sadman-showmik/Electromagnetic-Coupling-PCB/EM_Coupling/EM_Coupling_BOM.csv

Reference | Value | Footprint | QUANTITY
C1,C2,C3,C4,C9 | 0.1uF | Capacitor_THT:CP_Radial_Tantal_D6.0mm_P5.00mm | 5
C5,C7 | 0.1uF 250V film | Capacitor_THT:C_Rect_L13.0mm_W6.0mm_P10.00mm_FKS3_FKP3_MKS4 | 2
C6 | 470uF | Capacitor_THT:CP_Radial_Tantal_D7.0mm_P5.00mm | 1
C8 | 0.33uF | Capacitor_THT:CP_Radial_Tantal_D7.0mm_P5.00mm | 1
C10 | 10nF | Capacitor_THT:CP_Radial_Tantal_D6.0mm_P5.00mm | 1
C11 | 1nF | Capacitor_THT:CP_Radial_Tantal_D6.0mm_P5.00mm | 1
D1 | 1N5919BG | 3D_Models:DIOAD1405W86L465D235 | 1
D2,D3,D4,D5 | 1N4148 | 3D_Models:DIOAD1068W53L380D172 | 4
IC1 | IR2302SPBF | 3D_Models:SOIC127P600X175-8N | 1
IC2 | LM7805CT | 3D_Models:TO254P470X1028X1955-3P | 1
J1,J2,J3,J4,J5 | PinHeader_1x02 | Connector_PinHeader_2.54mm:PinHeader_1x02_P2.54mm_Vertical | 5
Q1,Q2 | IRFZ44NPBF | 3D_Models:TO254P483X1016X1994-3P | 2
R1 | 1k | Resistor_THT:R_Axial_DIN0204_L3.6mm_D1.6mm_P7.62mm_Horizontal | 1
R2 | 100 | Resistor_THT:R_Axial_DIN0204_L3.6mm_D1.6mm_P7.62mm_Horizontal | 1
R3 | 10 | Resistor_THT:R_Axial_DIN0204_L3.6mm_D1.6mm_P7.62mm_Horizontal | 1
R4 | 9.09k | Resistor_THT:R_Axial_DIN0204_L3.6mm_D1.6mm_P7.62mm_Horizontal | 1
S1 | EG1218 | 3D_Models:EG1218 | 1
U1 | NE555P | Package_DIP:DIP-8_W7.62mm | 1
