sadman-showmik/Electromagnetic-Coupling-PCB/EM_Coupling/EM_Coupling.pdf

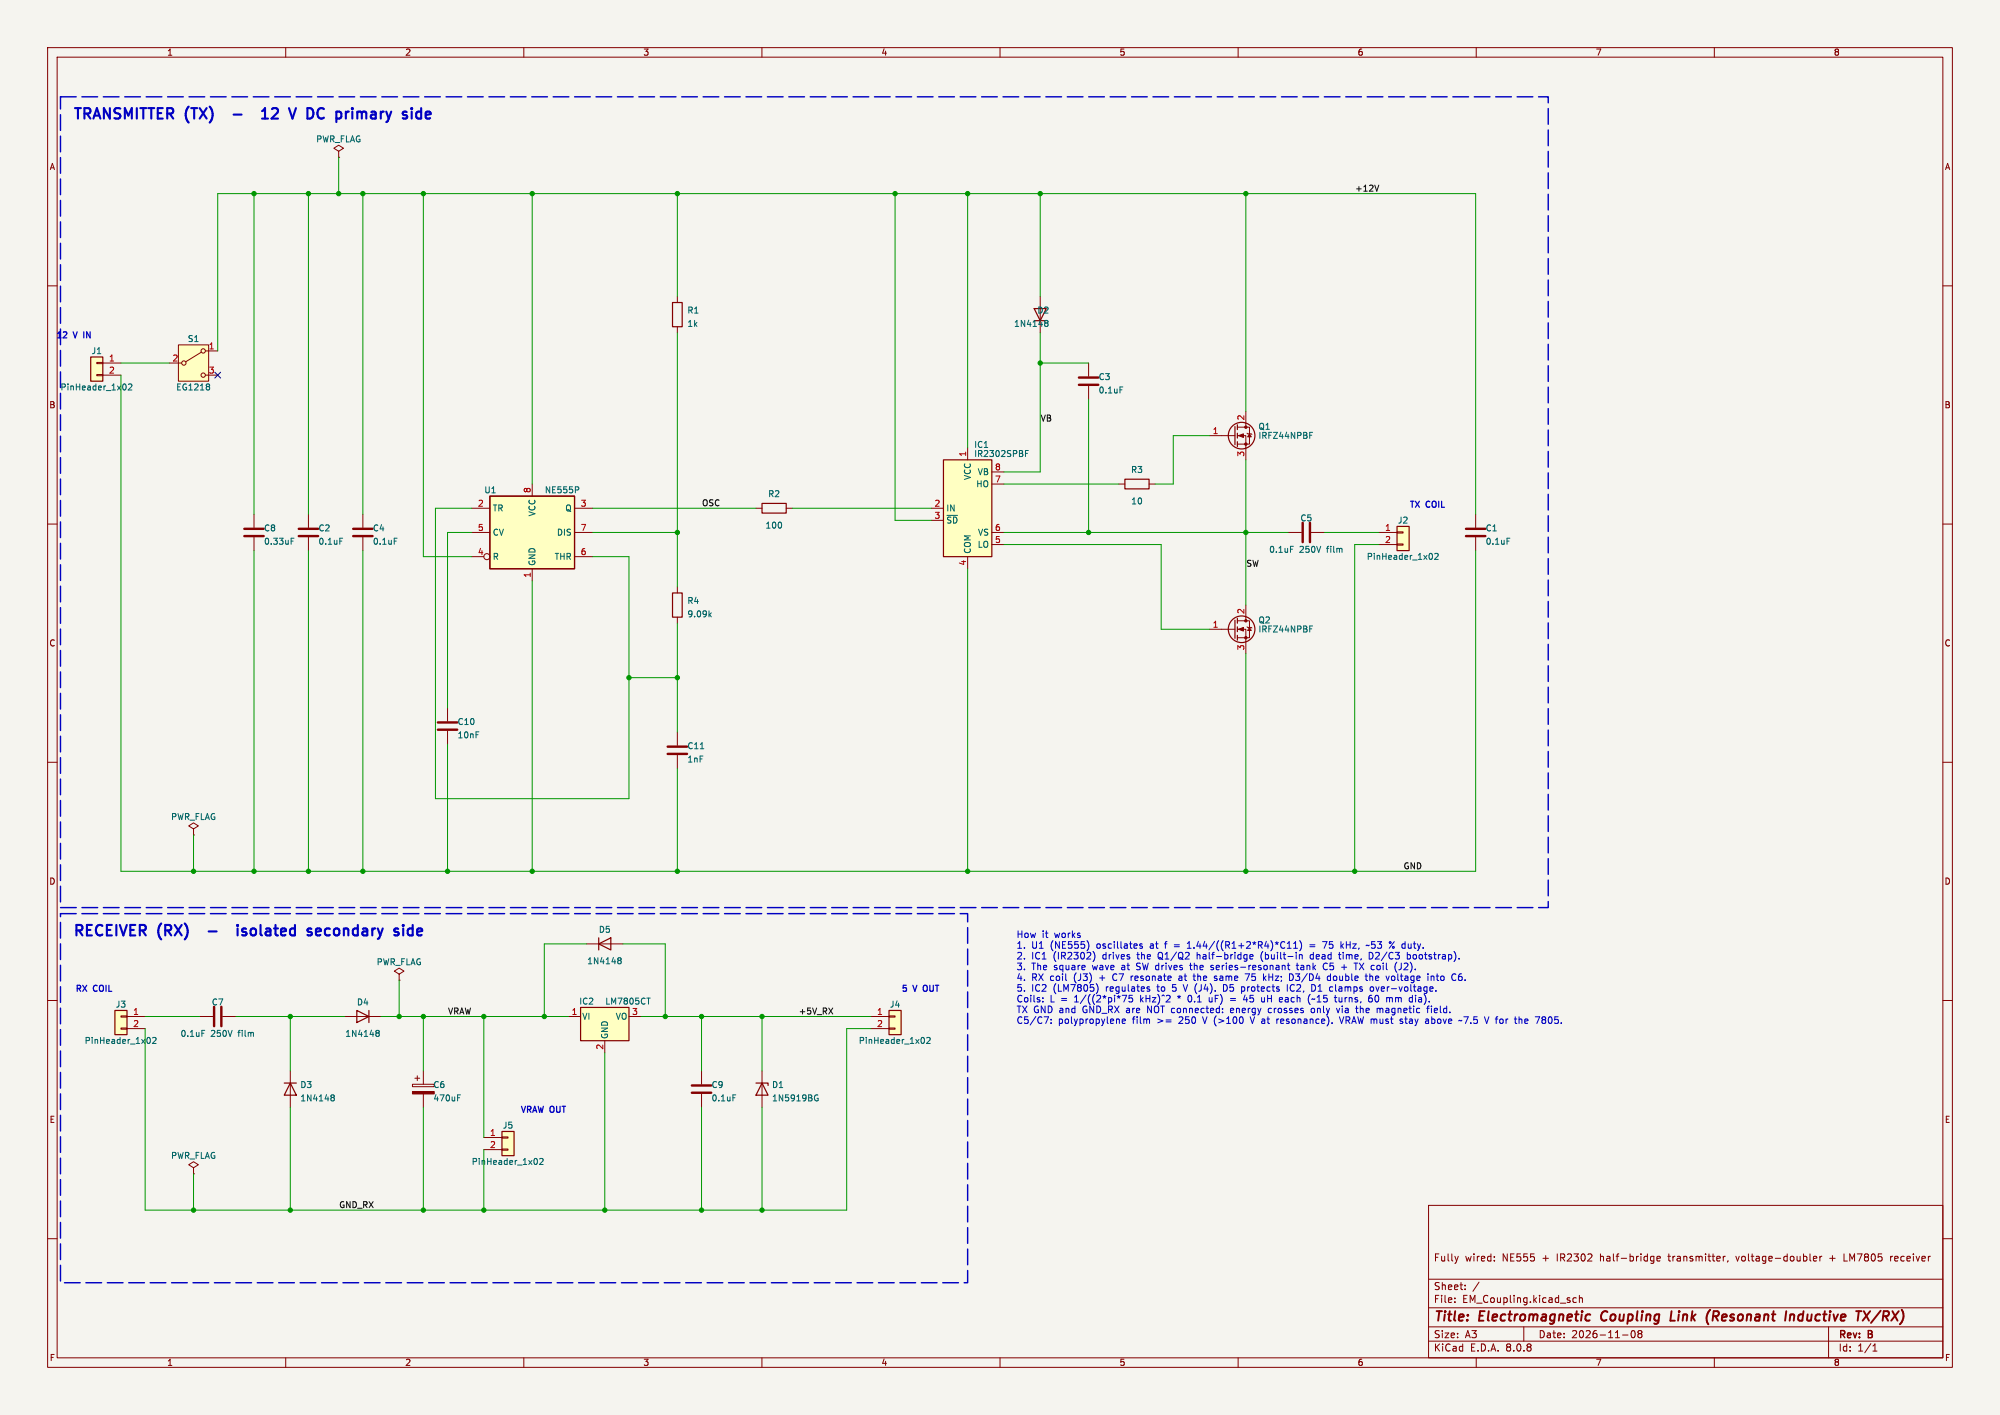
[picture p1: page 1]
