sadman-showmik/Electromagnetic-Coupling-PCB/EM_Coupling/EM_Coupling_PCB_bottom.pdf

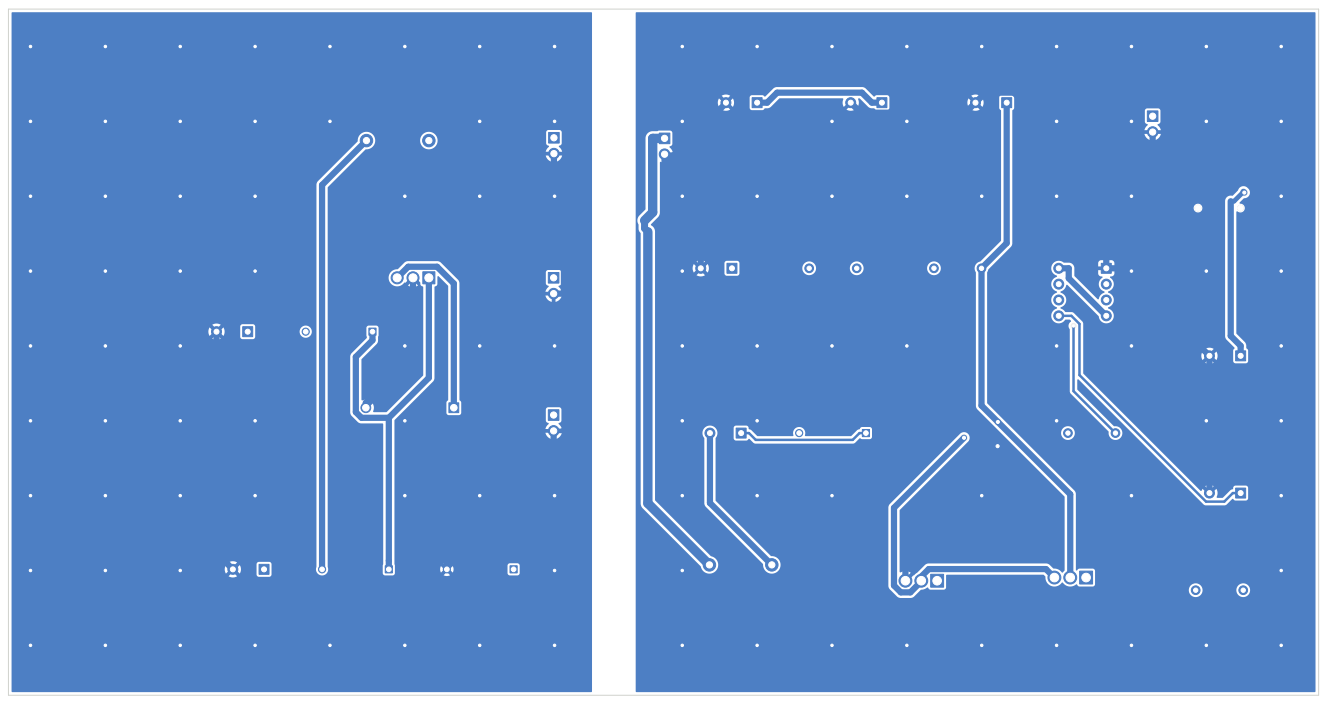
[picture p2: page 1]
