sadman-showmik/Electromagnetic-Coupling-PCB/EM_Coupling/EM_Coupling_PCB_top.pdf

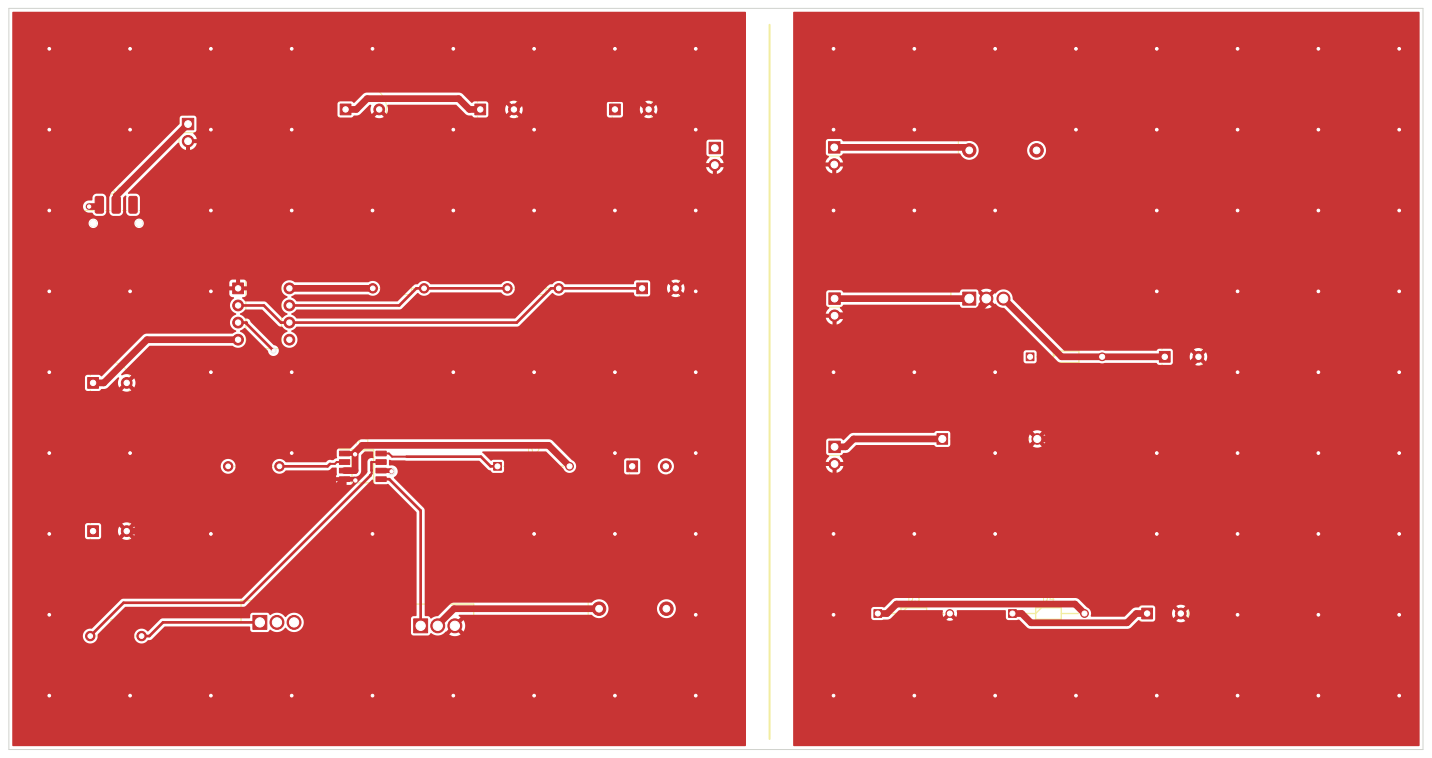
[picture p3: page 1]
