sadman-showmik/Electromagnetic-Coupling-PCB/(list of files, drawings)

Other design files:
EM_Coupling/EM_Coupling.dsn
