sadman-showmik/Electromagnetic-Coupling-PCB/EM_Coupling/EM_Coupling.kicad_pcb

## KiCad design EM_Coupling/EM_Coupling.kicad_pcb (2026-11-08)

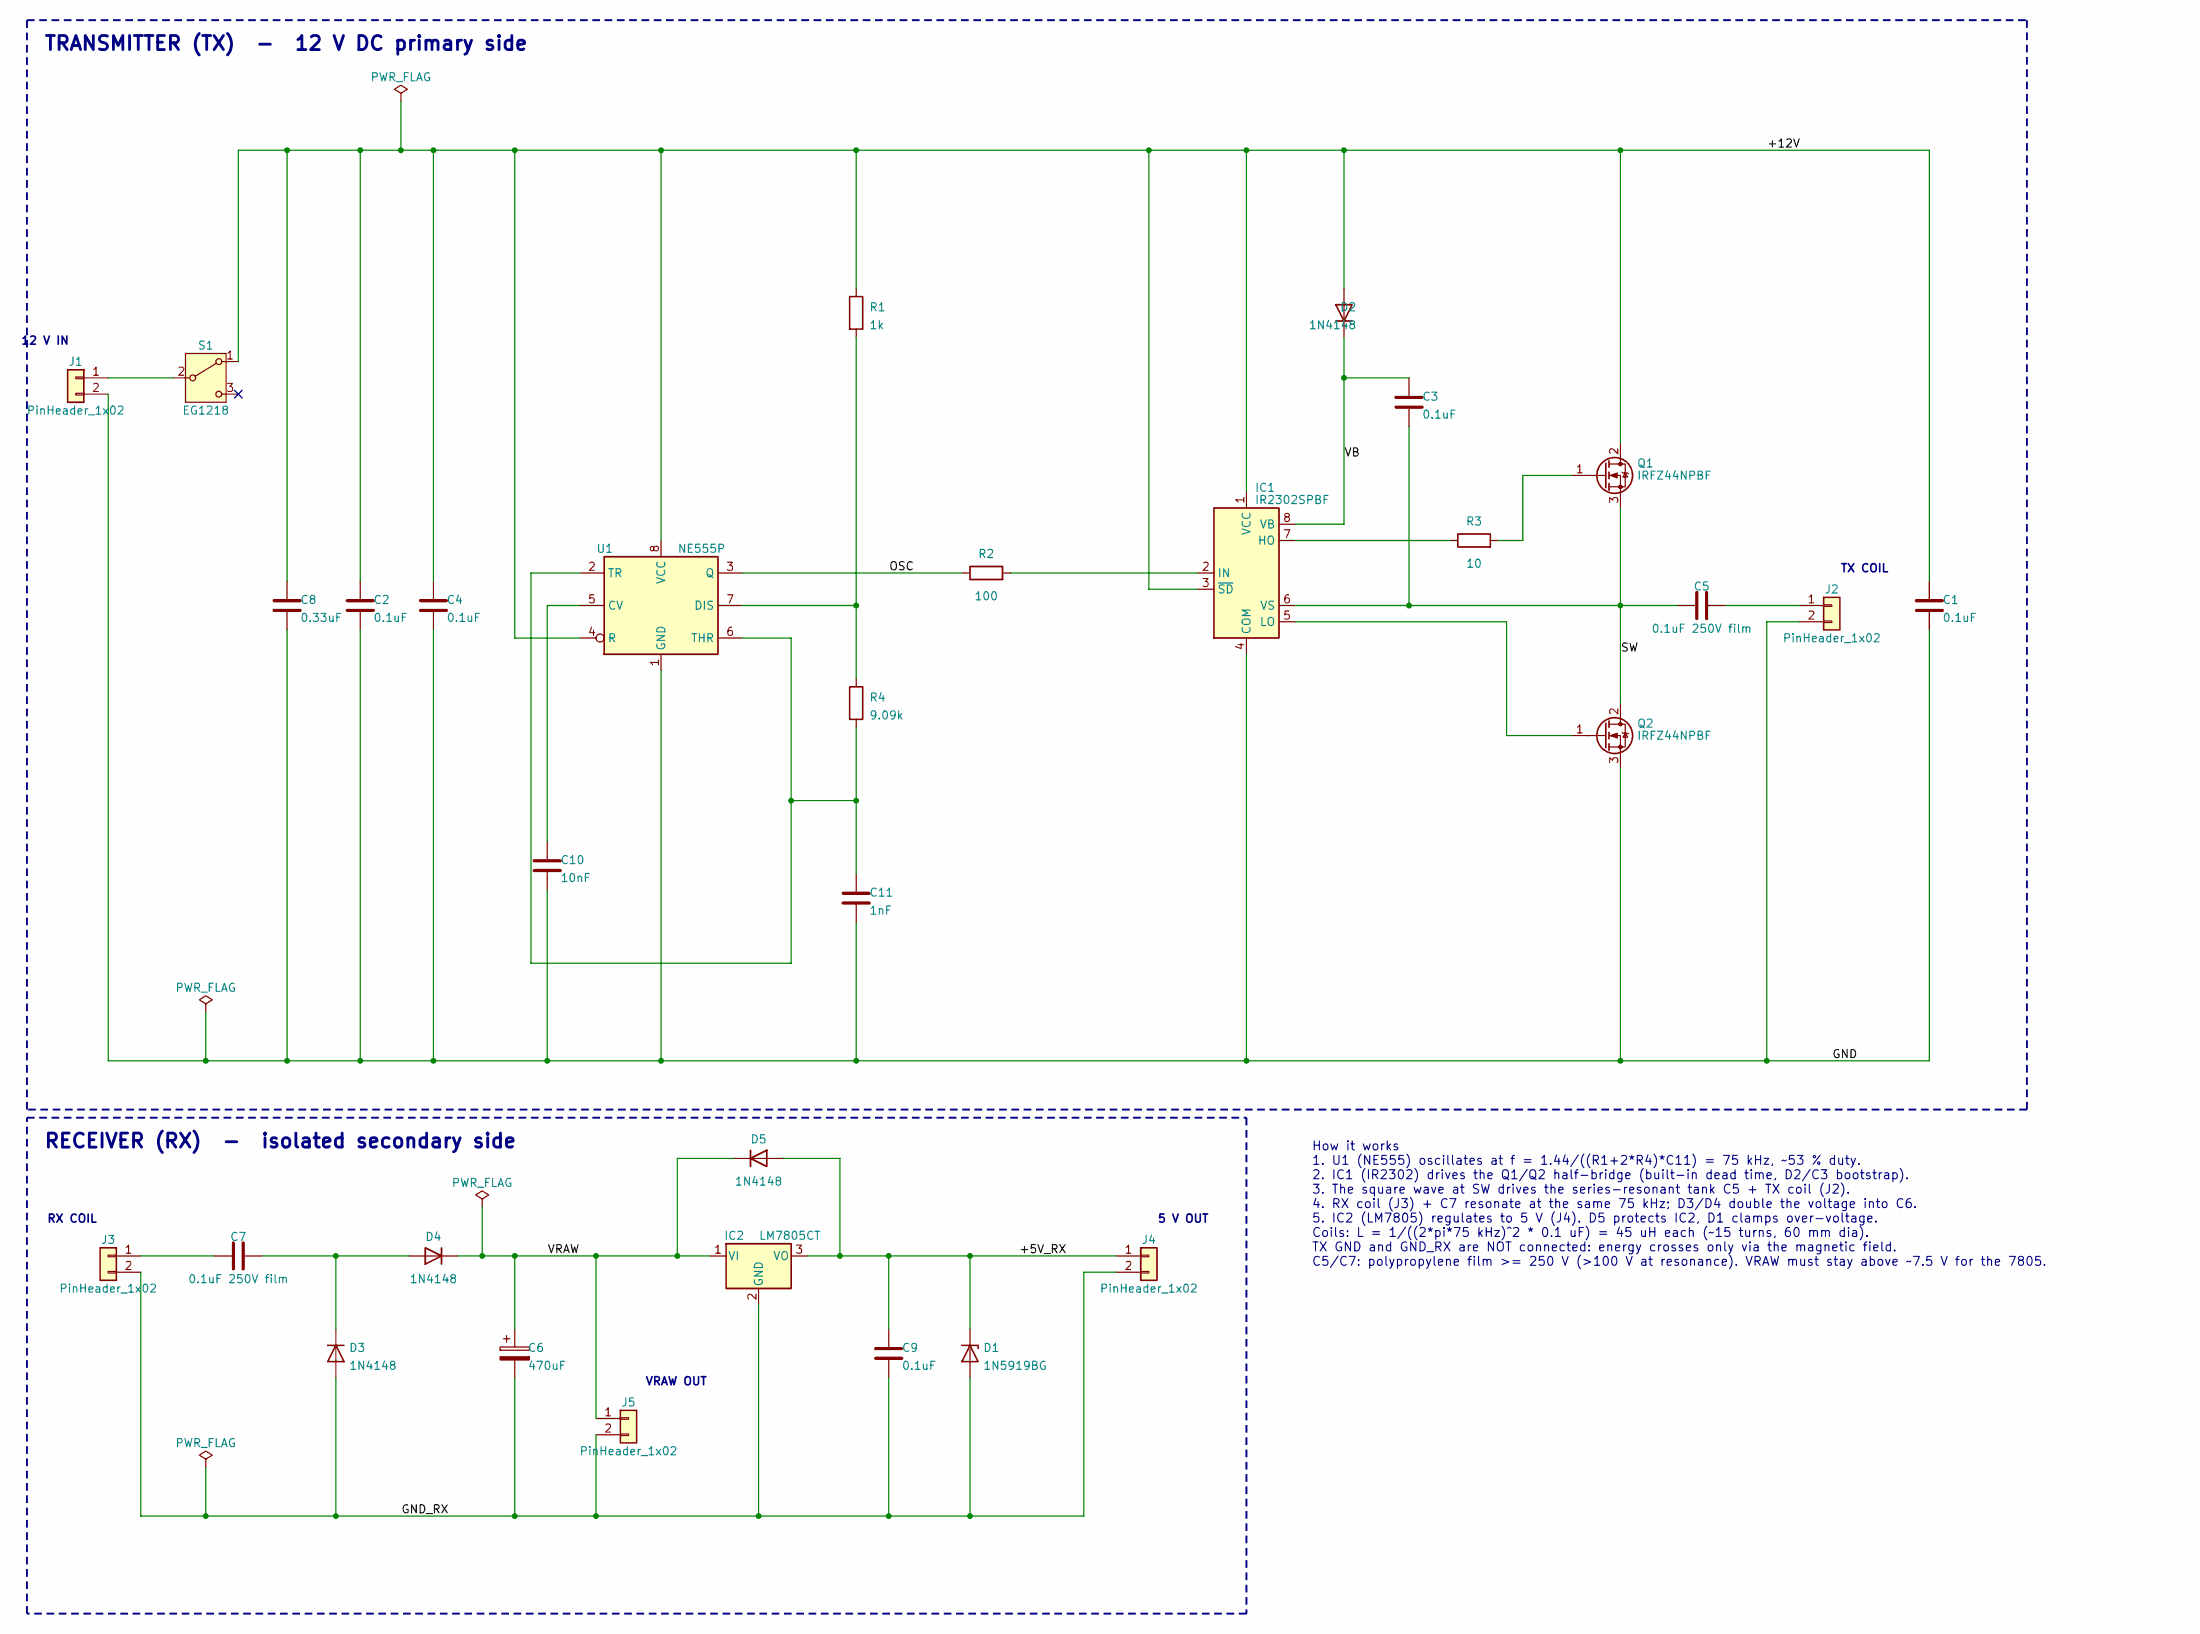
[picture p4: schematic EM_Coupling.kicad_sch, Electromagnetic Coupling Link (Resonant Inductive TX/RX)]

Parts:
C1, C2, C3, C4, C9: 0.1uF; CP_Radial_Tantal_D6.0mm_P5.00mm
C5, C7: 0.1uF 250V film; C_Rect_L13.0mm_W6.0mm_P10.00mm_FKS3_FKP3_MKS4
C6: 470uF; CP_Radial_Tantal_D7.0mm_P5.00mm
C8: 0.33uF; CP_Radial_Tantal_D7.0mm_P5.00mm
C10: 10nF; CP_Radial_Tantal_D6.0mm_P5.00mm
C11: 1nF; CP_Radial_Tantal_D6.0mm_P5.00mm
D1: 1N5919BG; DIOAD1405W86L465D235
D2, D3, D4, D5: 1N4148; DIOAD1068W53L380D172
IC1: IR2302SPBF; SOIC127P600X175-8N
IC2: LM7805CT; TO254P470X1028X1955-3P
J1, J2, J3, J4, J5: PinHeader_1x02; PinHeader_1x02_P2.54mm_Vertical
Q1, Q2: IRFZ44NPBF; TO254P483X1016X1994-3P
R1: 1k; R_Axial_DIN0204_L3.6mm_D1.6mm_P7.62mm_Horizontal
R2: 100; R_Axial_DIN0204_L3.6mm_D1.6mm_P7.62mm_Horizontal
R3: 10; R_Axial_DIN0204_L3.6mm_D1.6mm_P7.62mm_Horizontal
R4: 9.09k; R_Axial_DIN0204_L3.6mm_D1.6mm_P7.62mm_Horizontal
S1: EG1218; SW_SPDT_CK_JS102011SAQN
U1: NE555P; DIP-8_W7.62mm

Connections:
/+5V_RX: C9.1, D1.1 (K), D5.2 (A), IC2.3 (VO), J4.1
/+12V: C1.1, C2.1, C4.1, C8.1, D2.2 (A), IC1.1 (VCC), IC1.3 (~SD), Q1.2 (D), R1.1, S1.1 (A), U1.4 (R), U1.8 (VCC)
/GND: C1.2, C2.2, C4.2, C8.2, C10.2, C11.2, IC1.4 (COM), J1.2, J2.2, Q2.3 (S), U1.1 (GND)
/GND_RX: C6.2, C9.2, D1.2 (A), D3.2 (A), IC2.2 (GND), J3.2, J4.2, J5.2
/OSC: R2.1, U1.3 (Q)
/SW: C3.2, C5.1, IC1.6 (VS), Q1.3 (S), Q2.2 (D)
/VB: C3.1, D2.1 (K), IC1.8 (VB)
/VRAW: C6.1, D4.1 (K), D5.1 (K), IC2.1 (VI), J5.1
unnamed: C7.2, D3.1 (K), D4.2 (A)
unnamed: IC1.7 (HO), R3.1
unnamed: IC1.2 (IN), R2.2
unnamed: IC1.5 (LO), Q2.1 (G)
unnamed: J1.1, S1.2 (B)
unnamed: C5.2, J2.1
unnamed: C7.1, J3.1
unnamed: Q1.1 (G), R3.2
unnamed: C10.1, U1.5 (CV)
unnamed: R1.2, R4.1, U1.7 (DIS)
unnamed: C11.1, R4.2, U1.2 (TR), U1.6 (THR)

Notes on the sheet:
RX COIL
VRAW OUT
TRANSMITTER (TX) - 12 V DC primary side
RECEIVER (RX) - isolated secondary side
12 V IN
TX COIL
How it works 1. U1 (NE555) oscillates at f = 1.44/((R1+2*R4)*C11) = 75 kHz, ~53 % duty. 2. IC1 (IR2302) drives the Q1/Q2 half-bridge (built-in dead time, D2/C3 bootstrap). 3. The square wave at SW drives the series-resonant tank C5 + TX coil (J2). 4. RX coil (J3) + C7 resonate at the same 75 kHz; D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
5 V OUT

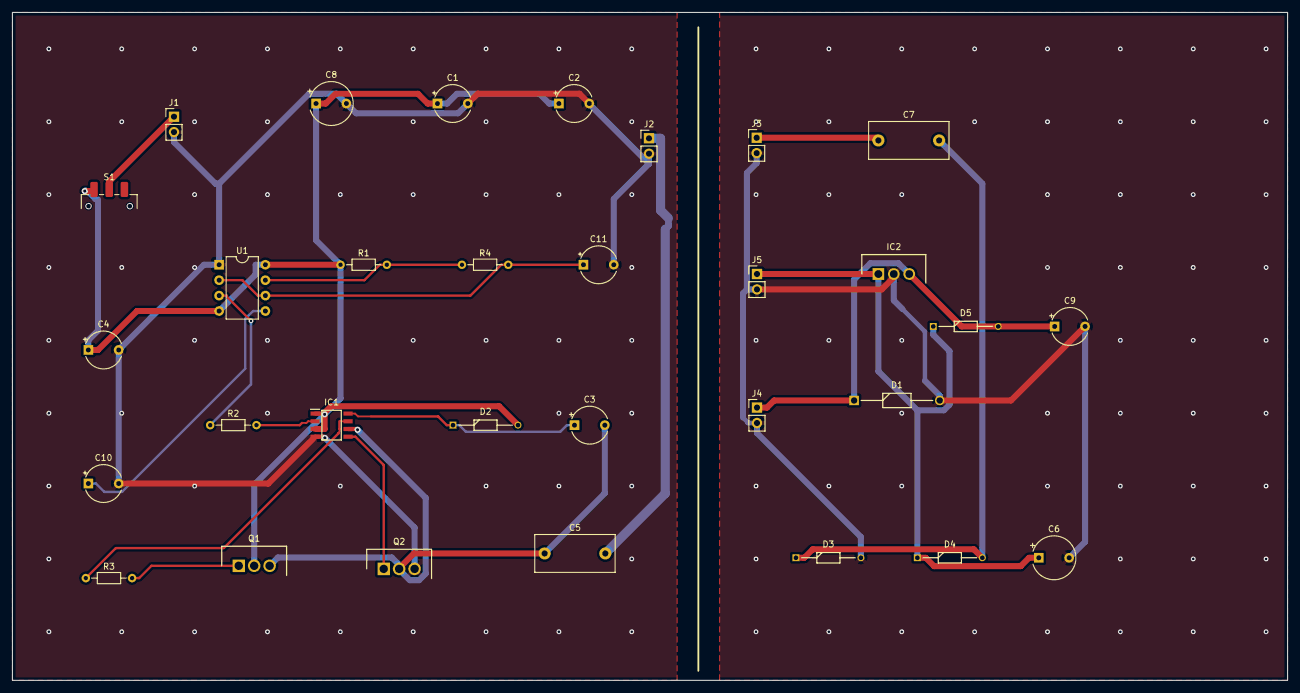
[picture p5: board EM_Coupling.kicad_pcb from above]

Board: 2 copper layers, 210.0 x 110.0 mm, 31 parts (0 on the bottom side), 19 nets.
