sadman-showmik/Electromagnetic-Coupling-PCB/(commit log)

2025-11-18 Revise README for Electromagnetic Coupling PCB
    Updated the README to provide a detailed overview of the PCB project, including features, repository contents, component list, and getting started instructions.
2026-11-08 Revise README for Electromagnetic Coupling Link project
    Updated README.md to reflect project changes and details.
